htl1-klagenfurt/SCC/README.md

<p align="center">
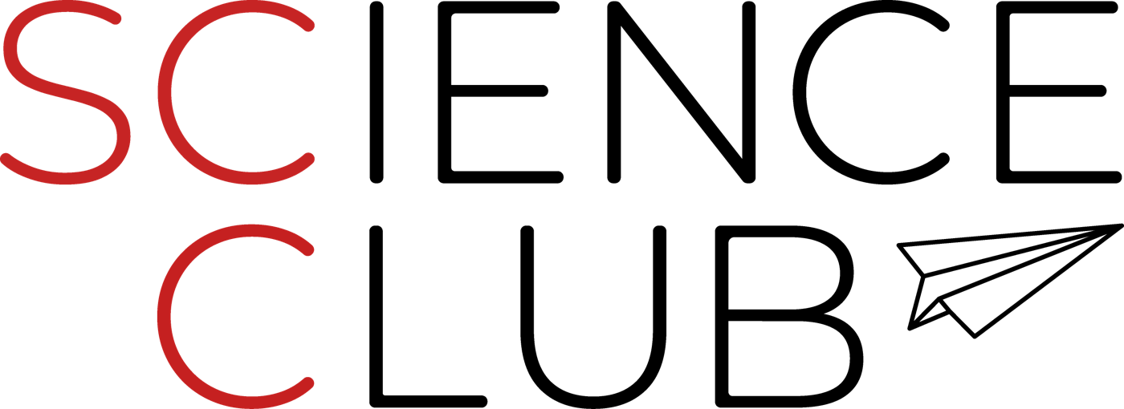
[picture p1: assets/science_club_logo.png]
Science Club
  
  &nbsp;&nbsp;&nbsp;&nbsp;
  <a href="https://htl1-klagenfurt.at">HTL1 Lastenstraße Klagenfurt</a>
</p>

# Science Club (SCC) – HTL1 Lastenstraße Klagenfurt

**Technik machen, nicht nur darüber reden.** · 🌐 [htl1-klagenfurt.github.io/SCC](https://htl1-klagenfurt.github.io/SCC/)

Im Science Club der [HTL1 Lastenstraße Klagenfurt](https://htl1-klagenfurt.at) entwickeln Schülerinnen und Schüler aus Elektrotechnik, Mechatronik und Maschinenbau echte Produkte: von der Idee über Elektronik, Software und 3D-gedrucktes Gehäuse bis zum fertigen Bausatz.

## Was ist ein Science Club?

Der Science Club ist eine unverbindliche Übung zur **Begabungs- und Begabtenförderung** in der Sekundarstufe I und II, mit einem Rahmencurriculum des Bildungsministeriums. Das Besondere sind die **Peer Groups**: Schülerinnen und Schüler der HTL1 (Sek II) entwickeln Projekte und geben ihr Wissen an Mittelschülerinnen und Mittelschüler (Sek I) weiter, die unter ihrer Anleitung selbst bauen. Im Mittelpunkt stehen Kreativität, kritisches Denken, Kommunikation und Kooperation.

## Die Idee: Lernen auf Augenhöhe

- **Machen:** Echte Projekte statt Übungen. Die Schülerinnen und Schüler entwickeln selbstständig, die Lehrer coachen.
- **Erklären:** Peer-Teaching. Wer etwas gebaut hat, gibt sein Wissen an Mittelschülerinnen und Mittelschüler weiter, die den Bausatz unter Anleitung selbst bauen und verstehen.
- **Raum:** Gemeinsam mit den Schülerinnen und Schülern haben wir die **Co-Creation Corner** geschaffen, selbst geplant, verkabelt und gebaut. Mit 3D-Drucker, Werkzeug, Laptops und Couch gibt sie dem Science Club Platz für die nächsten Projekte.

<sub>Science-Club-Konzept: DI(FH) Bernd Hollauf, MSc und DI Theodor Kranz, BSc BEd</sub>

## Projekte

| Projekt | Inhalt | Status |
|---|---|---|
| [**TimeFlow – die digitale Sanduhr**](timeflow/) | LED-Sanduhr mit zwei 8×8-Matrizen, Lagesensor und Akku im 3D-gedruckten Gehäuse | Prototyp und Workshops 2026 |

## Was passiert gerade?

| | |
|---|---|
| 🔜 **Als Nächstes** | Ende November / Anfang Dezember 2026: neue Workshops mit der MS Wölfnitz |
| ▶️ **Läuft gerade** | TimeFlow ist ein offener Bausatz: Firmware, Schaltplan, Druckdateien und Anleitungen sind online |
| ✅ **Zuletzt** | Sommersemester 2026: eigene Co-Creation Corner an der HTL1, von den Schüler:innen selbst geplant, verkabelt und gebaut · zwei Workshops mit der MS Wölfnitz |

Alle Stationen von der ersten Idee bis heute stehen im **[Logbuch](LOGBUCH.md)**.

## Nachbauen erlaubt, mit Namensnennung

Alle Unterlagen in diesem Repository dürfen für Unterricht, Workshops und private Projekte nachgebaut und angepasst werden. Bedingung ist, dass die HTL1 Lastenstraße Klagenfurt als Urheberin genannt, verlinkt und sichtbar gemacht wird. Details stehen in [ATTRIBUTION.md](ATTRIBUTION.md), die Lizenz in [LICENSE.md](LICENSE.md).

---

<sub>Science Club · HTL1 Lastenstraße Klagenfurt · Lastenstraße 1, 9020 Klagenfurt am Wörthersee · [htl1-klagenfurt.at](https://htl1-klagenfurt.at)</sub>
