htl1-klagenfurt/SCC/LOGBUCH.md

# Logbuch – Science Club HTL1

Was war, was läuft, was kommt. Neueste Einträge oben.

---

## 🔜 Als Nächstes

- [ ] **Ende November / Anfang Dezember 2026: neue Workshops mit der MS Wölfnitz** in der Co-Creation Corner
- [ ] **Nächstes SCC-Projekt** festlegen

## ▶️ Läuft gerade

- **Oktober 2026:** TimeFlow ist ein offener Bausatz. Firmware, Schaltplan, 3D-Druckdateien, Aufbau- und Bedienungsanleitung sind online.

## ✅ Was war

### Mai 2026: Zwei Workshops mit der MS Wölfnitz
Am 20. und 27. Mai bauen 12 Schülerinnen und Schüler der 4. Klassen der MS Wölfnitz ihre eigene, personalisierte TimeFlow und nehmen sie mit nach Hause. Unsere SCC-Mitglieder betreuen als Peer-Teacher vier Stationen: Programmierung, Konstruktion, 3D-Druck sowie Elektronik und Löten. Am Ende hält jede Gruppe eine eigene TimeFlow in der Hand.

### Sommersemester 2026: Ein eigener Raum: die Co-Creation Corner
Gemeinsam mit den Schülerinnen und Schülern entsteht an der HTL1 die Co-Creation Corner, ein eigener Raum für den Science Club mit 3D-Drucker, Werkzeug, Laptops und Couch. Die Schülerinnen und Schüler haben ihn selbst mitgestaltet: geplant, verkabelt und aufgebaut.

### Mai 2026: TimeFlow ist fertig
Gehäuse, Elektronik und Firmware sind fertig: Sanduhr, Uhr mit Wecker, Temperatur- und Feuchteanzeige und versteckte Easter Eggs. Auf der Rückseite führt ein QR-Code direkt zu diesem Repository.

### März 2026: Erste Prototypen
Die Elektronik läuft auf dem Steckbrett, der Sand „rieselt“ über zwei LED-Matrizen. Erste Gehäuse-Entwürfe entstehen im CAD.

### Februar 2026: Kick-off TimeFlow
14 Schülerinnen und Schüler aus Elektrotechnik, Mechatronik und Maschinenbau starten die Entwicklung. Ziel: eine digitale Sanduhr als Bausatz, den Mittelschüler unter Anleitung selbst bauen und verstehen.

### Dezember 2025: Planung der Co-Creation Corner
Grundriss und Farbkonzept für den eigenen Makerspace entstehen.

### Herbst 2025: Start des Science Club
Die HTL1 wird Teil der Science Club Community Carinthia (mit HTL Villach und Kärntner Mittelschulen). Erstes Planungstreffen mit der MS Wölfnitz. Ursprünglich war eine Sanduhr mit CO₂-Messung geplant, umgesetzt wurde sie mit Temperatur- und Feuchtemessung, damit der Bausatz einfach und robust bleibt.

---

<sub>Neuer Eintrag? Oben unter „Als Nächstes“ oder „Läuft gerade“ ergänzen und erledigte Punkte mit Datum nach „Was war“ verschieben.</sub>
