htl1-klagenfurt/SCC/ATTRIBUTION.md

# Namensnennung und Branding

TimeFlow und alle weiteren Projekte in diesem Repository wurden vom **Science Club der HTL1 Lastenstraße Klagenfurt** entwickelt. Wer sie nachbaut, weiterentwickelt, in Workshops einsetzt oder darüber berichtet, muss das sichtbar machen.

## Pflicht bei jeder Nutzung

1. **Nennen**, und zwar mit diesem Text (Deutsch oder Englisch):

   > **TimeFlow – ein Projekt des Science Club der HTL1 Lastenstraße Klagenfurt**
   > *TimeFlow – a project by the Science Club of HTL1 Lastenstraße Klagenfurt, Austria*

2. **Verlinken** auf beide Adressen:
   - https://htl1-klagenfurt.at
   - https://github.com/htl1-klagenfurt/SCC

3. **Sichtbar machen**
   - **Am Gerät:** Das Namensfeld „HTL1 Lastenstraße“ am Gehäuse bleibt erhalten. Wer das Gehäuse neu gestaltet, bringt den Hinweis „Design: HTL1 Lastenstraße Klagenfurt“ gut lesbar am Gerät an.
   - **In Unterlagen, Präsentationen, Websites und Social Media:** Der Nennungstext aus Punkt 1 und das HTL1-Logo erscheinen dort, wo das Projekt gezeigt wird.

4. **Änderungen kennzeichnen**, zum Beispiel: „Basierend auf TimeFlow der HTL1 Lastenstraße Klagenfurt, angepasst von …“

## Logos

Das HTL1-Logo und das Science-Club-Logo im Ordner [`assets/`](assets/) dürfen **nur zur Namensnennung** verwendet werden: unverändert und ohne den Eindruck, die HTL1 würde ein fremdes Produkt empfehlen oder verantworten. Die Logos fallen **nicht** unter die offene Lizenz dieses Repositorys.

## Kommerzielle Nutzung

Der Verkauf von Bausätzen, Geräten oder Kursen auf Basis von TimeFlow ist nur mit schriftlicher Zustimmung der HTL1 Lastenstraße Klagenfurt erlaubt.

## Kontakt

Science Club · HTL1 Lastenstraße Klagenfurt · Lastenstraße 1, 9020 Klagenfurt am Wörthersee · [htl1-klagenfurt.at](https://htl1-klagenfurt.at)
