htl1-klagenfurt/SCC/assets/corner/entwurf_ansicht.jpg

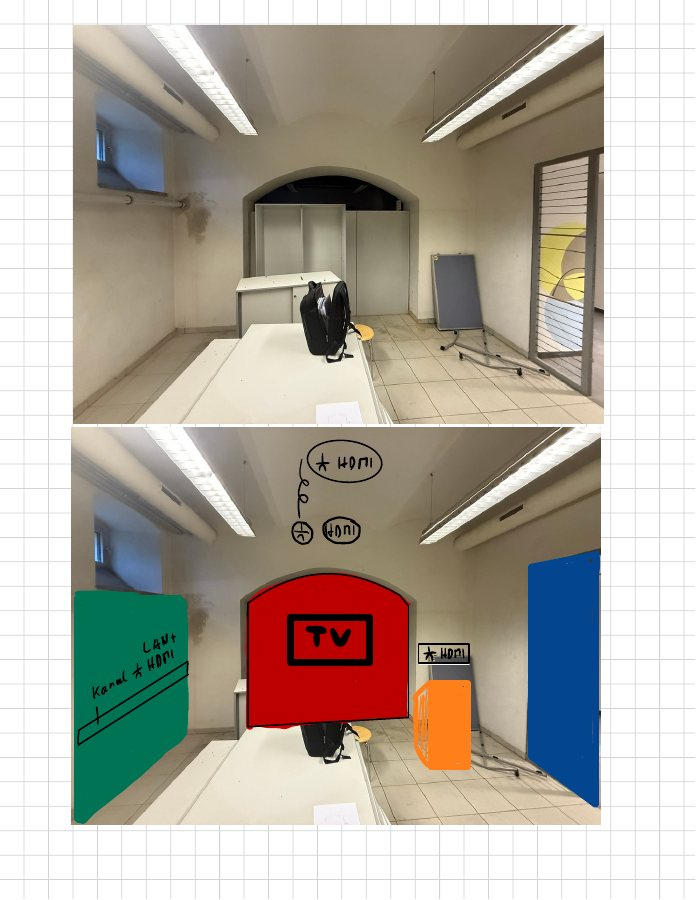
assets/corner/entwurf_ansicht.jpg
