htl1-klagenfurt/SCC/assets/corner/entwurf_grundriss.jpg

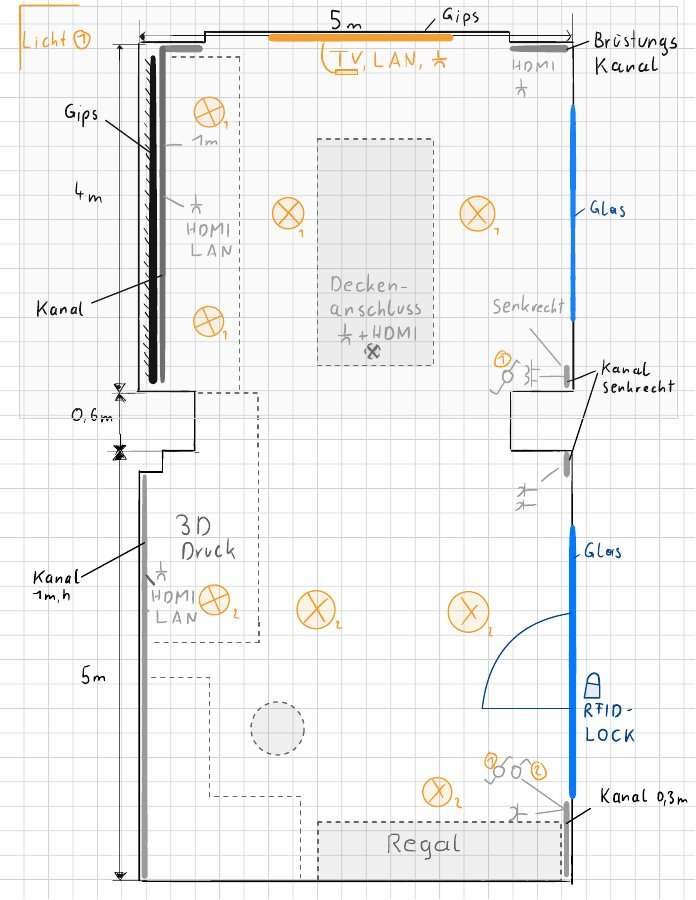
assets/corner/entwurf_grundriss.jpg
