htl1-klagenfurt/SCC/assets/corner/plakat_co_creation_corner.jpg

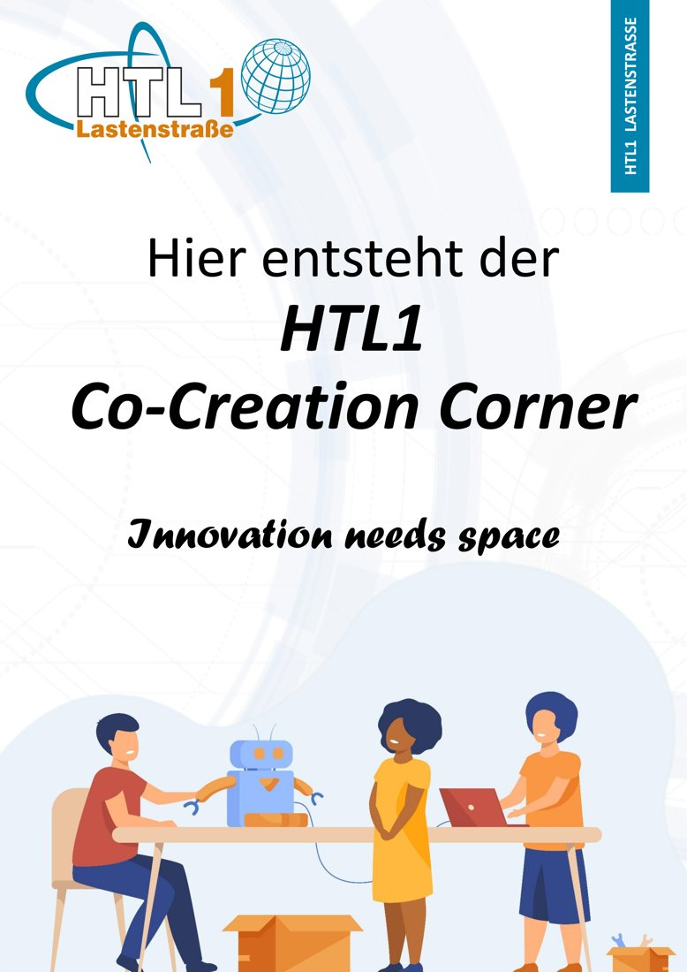
assets/corner/plakat_co_creation_corner.jpg
