htl1-klagenfurt/SCC/assets/corner/raum_vorher.jpg

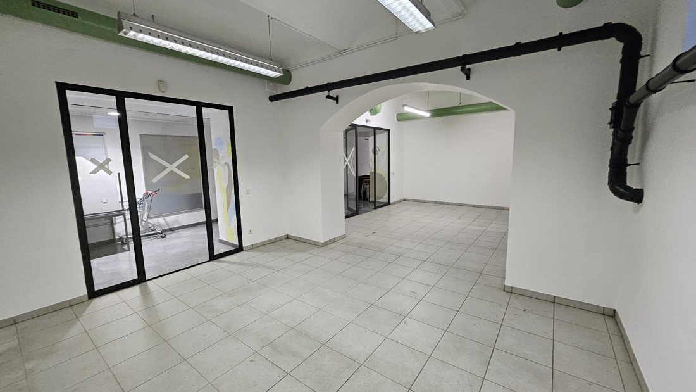
assets/corner/raum_vorher.jpg
