htl1-klagenfurt/SCC/assets/corner/team_co_creation_corner.jpg

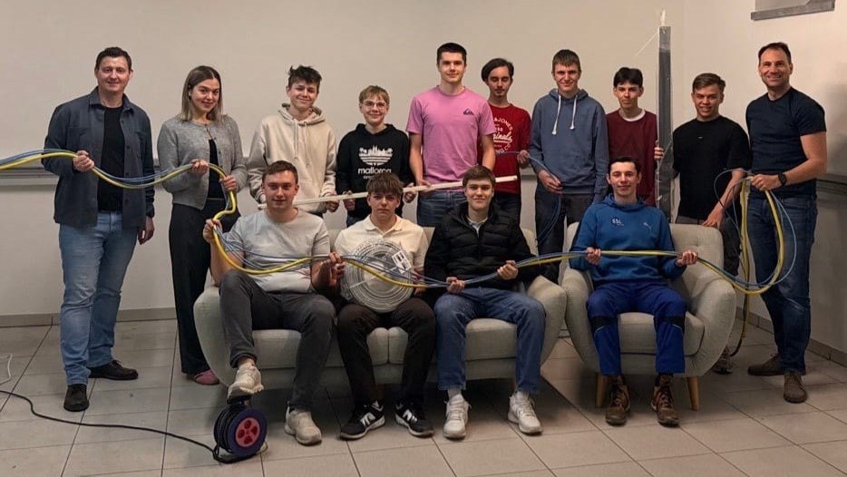
assets/corner/team_co_creation_corner.jpg
