htl1-klagenfurt/SCC/timeflow/bilder/foto_gehaeuse_offen.jpg

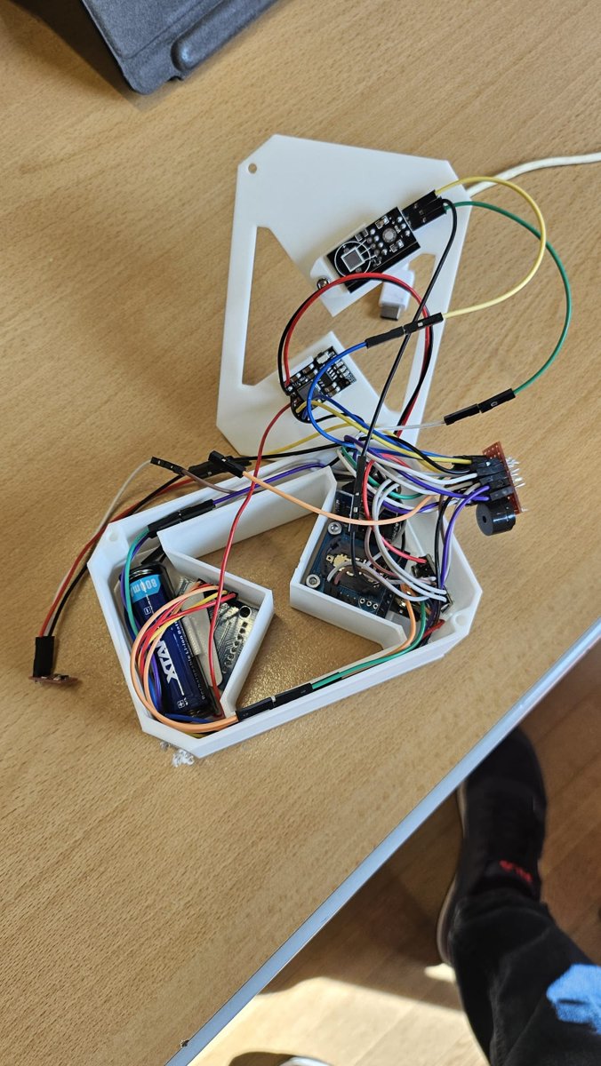
timeflow/bilder/foto_gehaeuse_offen.jpg
