htl1-klagenfurt/SCC/timeflow/bilder/foto_steckplatine.jpg

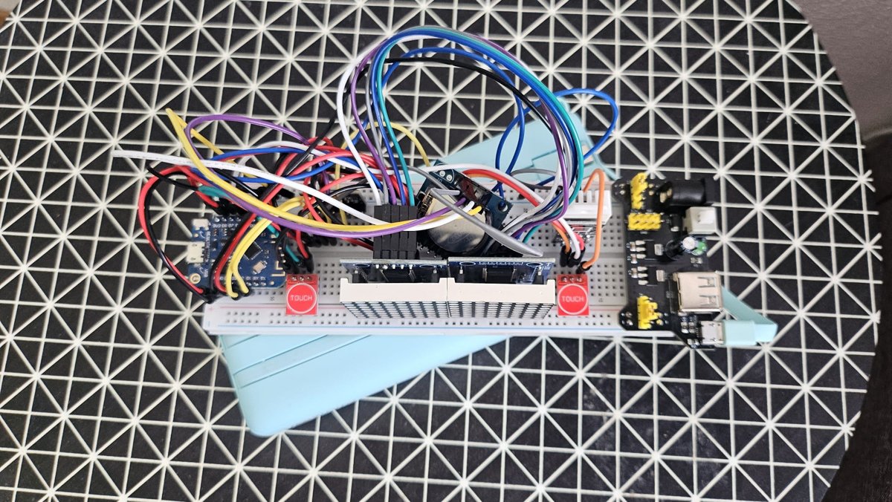
timeflow/bilder/foto_steckplatine.jpg
