htl1-klagenfurt/SCC/timeflow/bilder/foto_temperaturanzeige.jpg

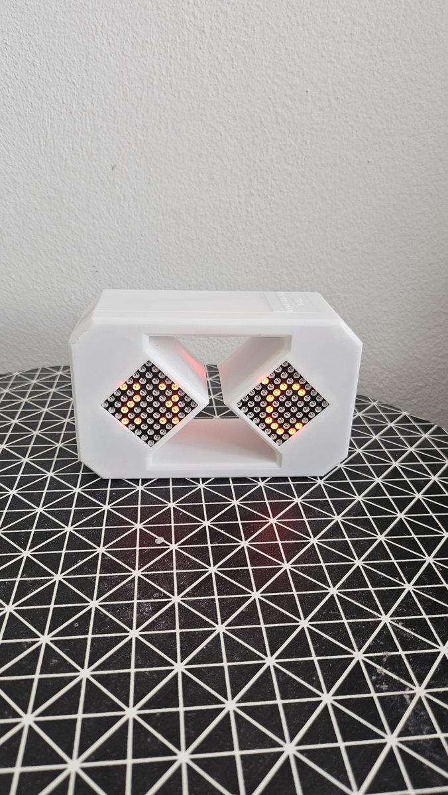
timeflow/bilder/foto_temperaturanzeige.jpg
