htl1-klagenfurt/SCC/timeflow/bilder/gehaeuse_cad_ansichten.jpg

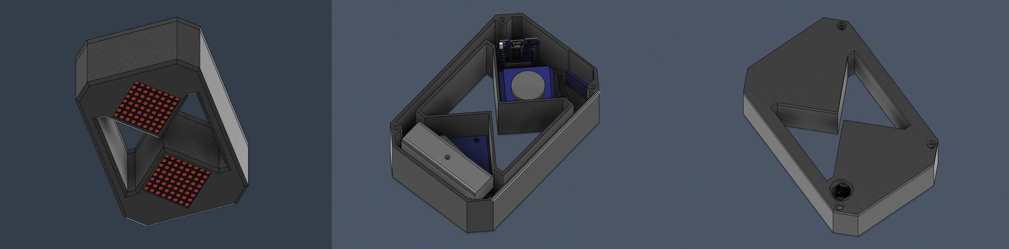
timeflow/bilder/gehaeuse_cad_ansichten.jpg
