htl1-klagenfurt/SCC/timeflow/bilder/gehaeuse_cad_offen.jpg

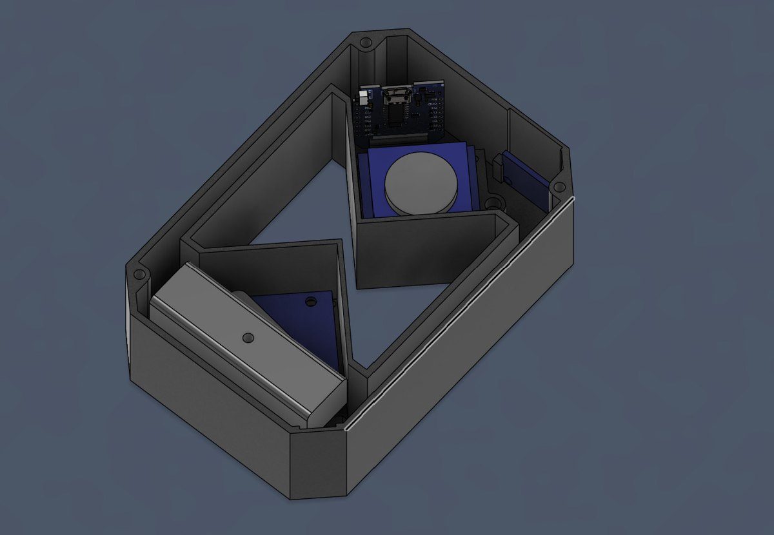
timeflow/bilder/gehaeuse_cad_offen.jpg
