htl1-klagenfurt/SCC/timeflow/bilder/gehaeuse_cad_rueckseite.jpg

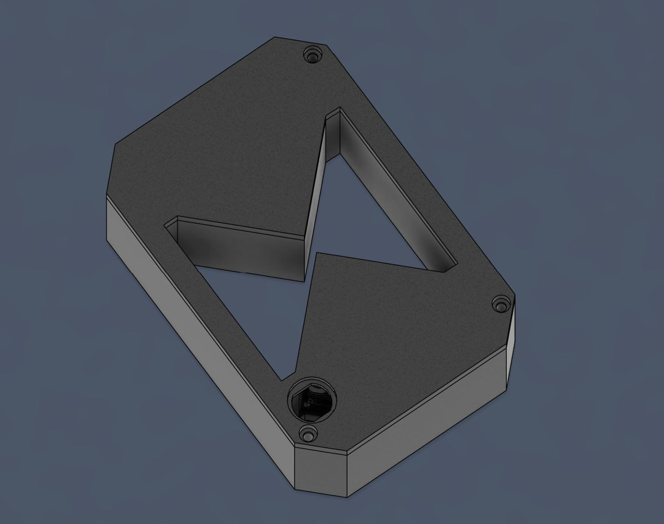
timeflow/bilder/gehaeuse_cad_rueckseite.jpg
