htl1-klagenfurt/SCC/timeflow/bilder/kickoff.jpg

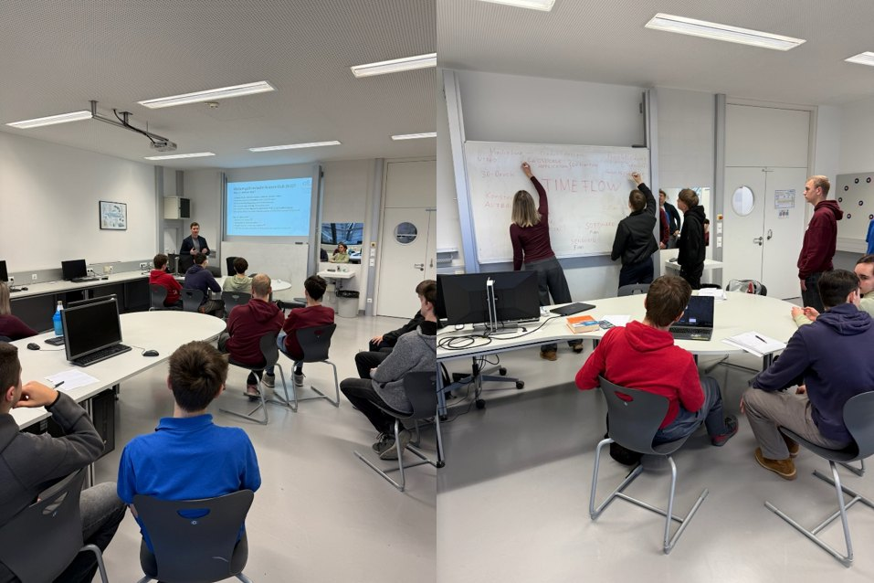
timeflow/bilder/kickoff.jpg
