htl1-klagenfurt/SCC/timeflow/bilder/plakat_htl1_trifft_ms_woelfnitz.jpg

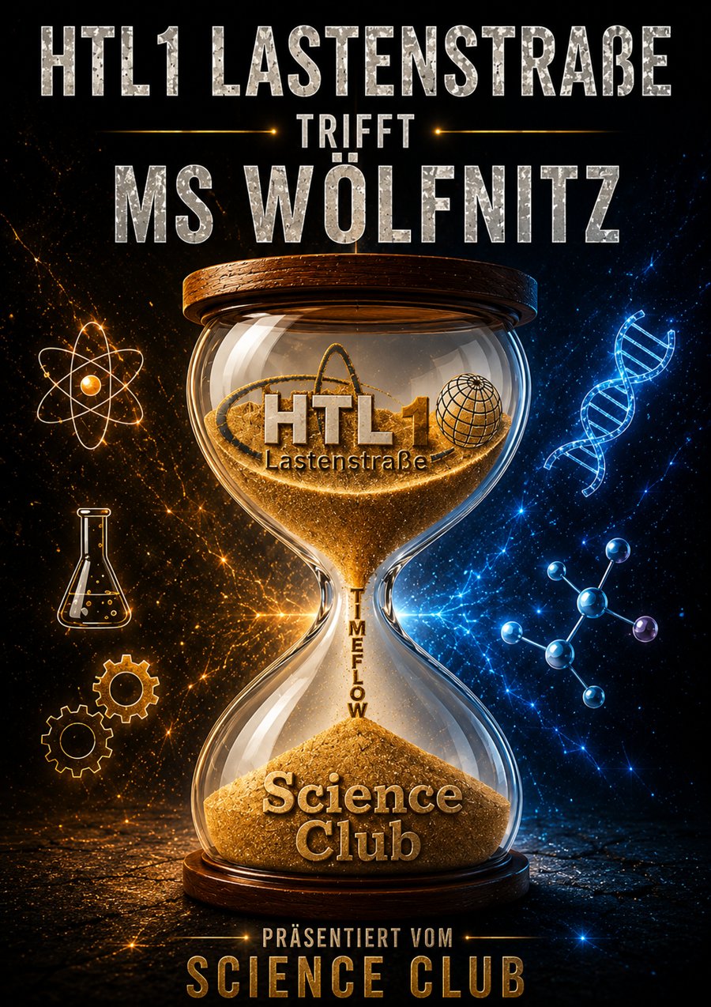
timeflow/bilder/plakat_htl1_trifft_ms_woelfnitz.jpg
