htl1-klagenfurt/SCC/timeflow/bilder/plakat_sanduhr_science_club.jpg

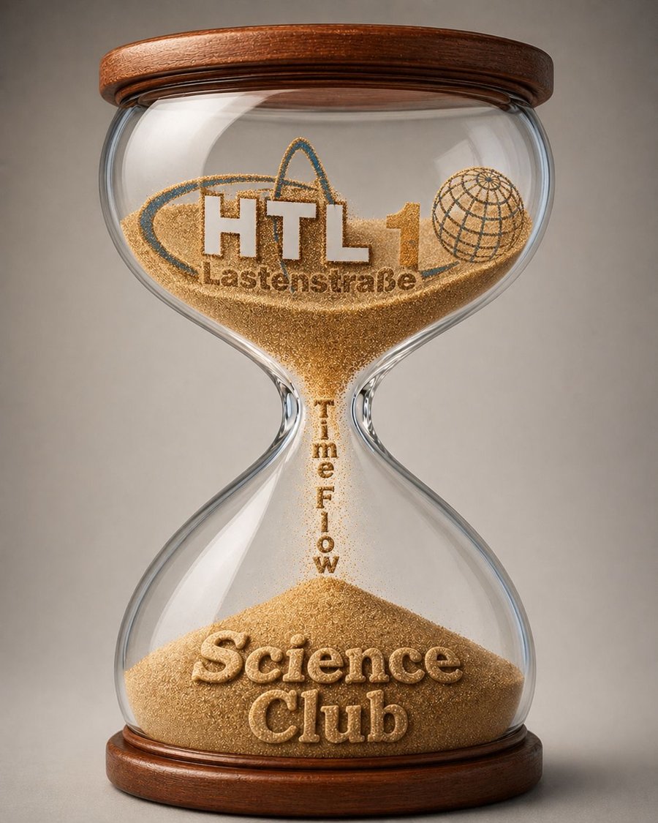
timeflow/bilder/plakat_sanduhr_science_club.jpg
