htl1-klagenfurt/SCC/timeflow/bilder/prototyp_sand.jpg

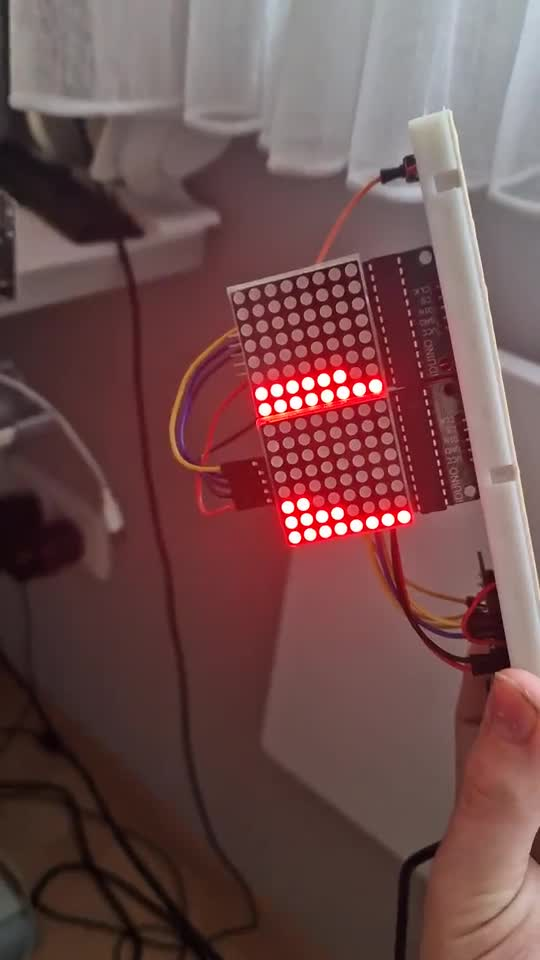
timeflow/bilder/prototyp_sand.jpg
