htl1-klagenfurt/SCC/timeflow/bilder/prototyp_steckbrett.jpg

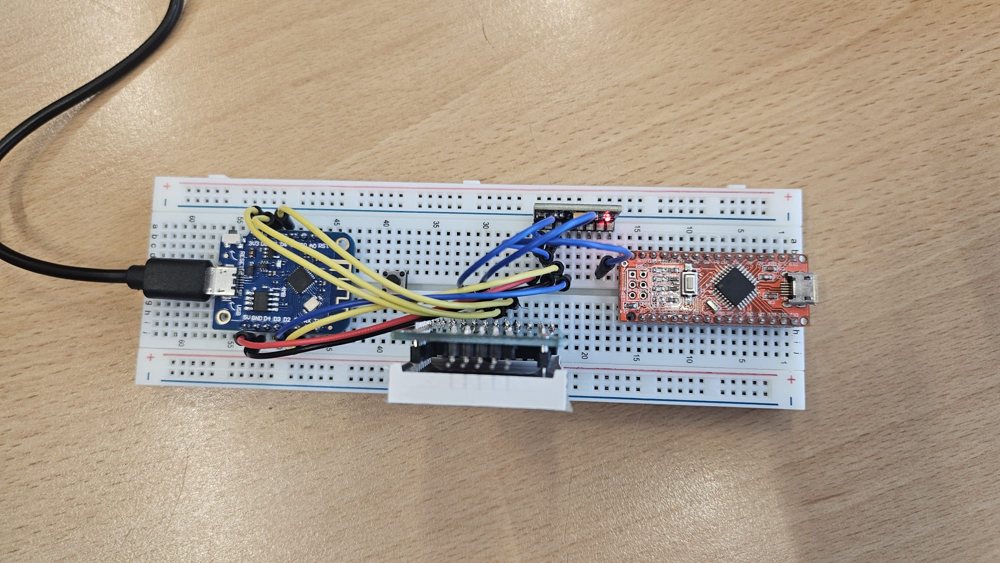
timeflow/bilder/prototyp_steckbrett.jpg
