htl1-klagenfurt/SCC/timeflow/bilder/timeflow_blau_modi.jpg

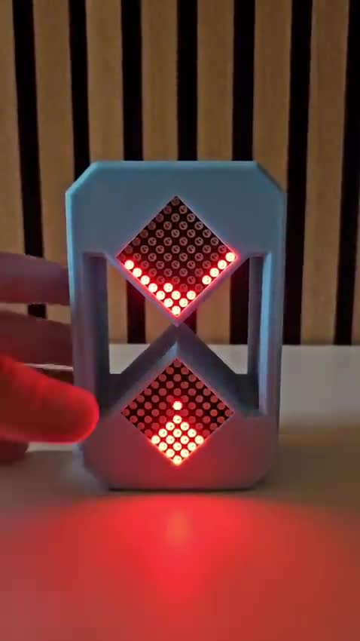
timeflow/bilder/timeflow_blau_modi.jpg
