htl1-klagenfurt/SCC/timeflow/bilder/timeflow_final.jpg

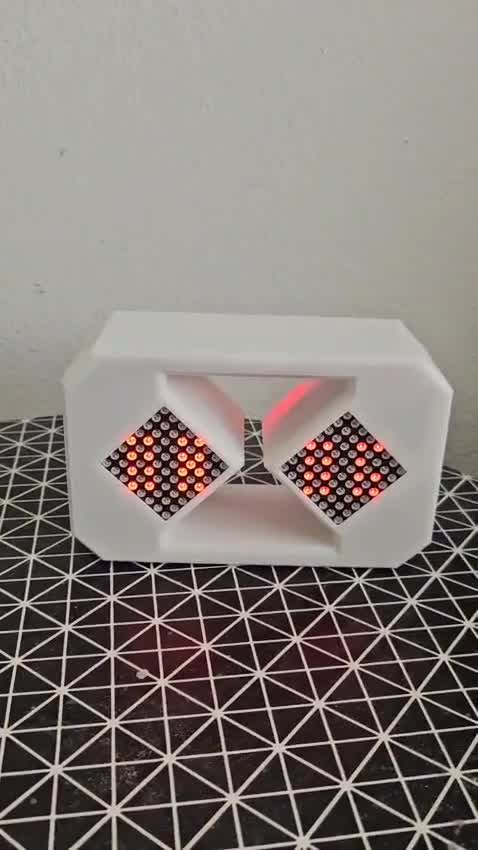
timeflow/bilder/timeflow_final.jpg
