htl1-klagenfurt/SCC/timeflow/cad/uhr_modul_halterung.step

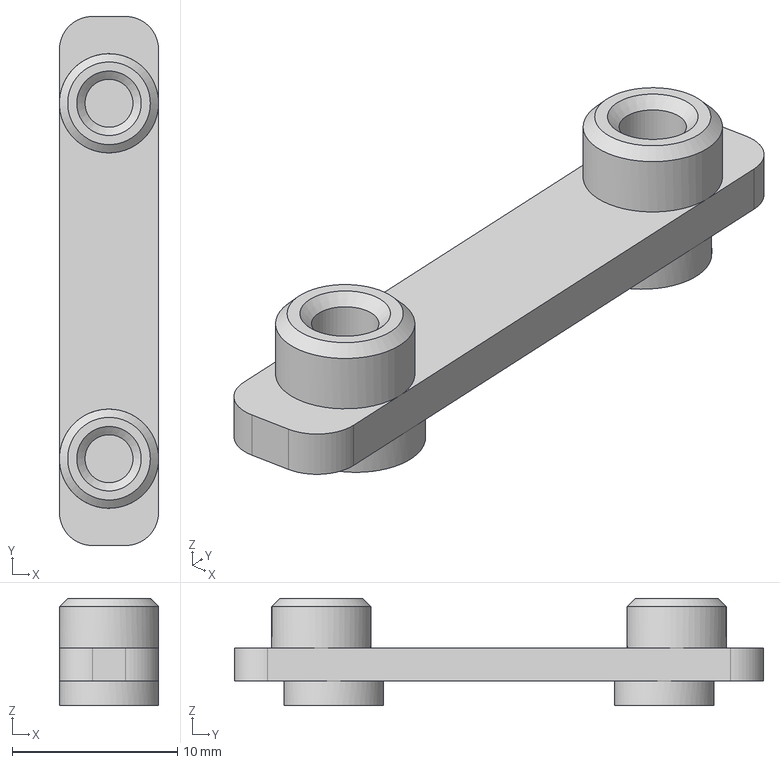
[picture p22: CAD file, 2026-10-20]
timeflow/cad/uhr_modul_halterung.step
6.00 x 32.0 x 6.50 mm
