htl1-klagenfurt/SCC/timeflow/druckdateien/02_Wand.3mf

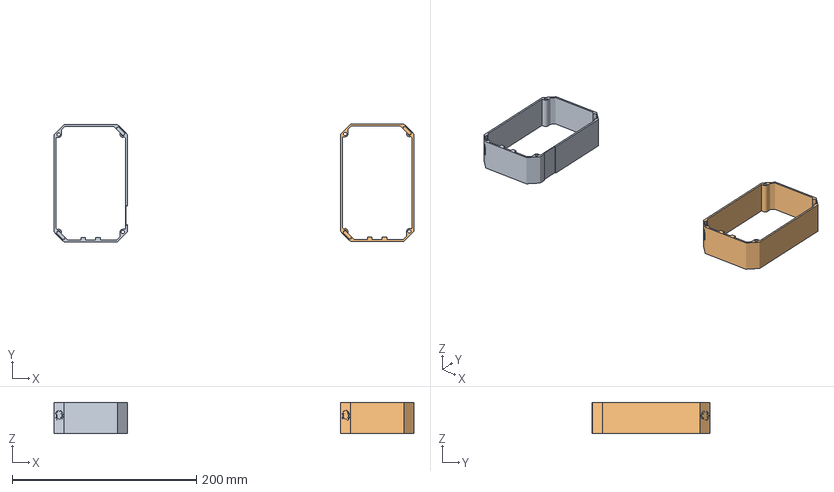
[picture p23: CAD file, 2026-10-20]
timeflow/druckdateien/02_Wand.3mf
390.9 x 128.3 x 34.0 mm
cad_md_Wand.step
cad_md_wand_ohne_namensfeld.step
