htl1-klagenfurt/SCC/timeflow/cad/wand_ohne_namensfeld.step

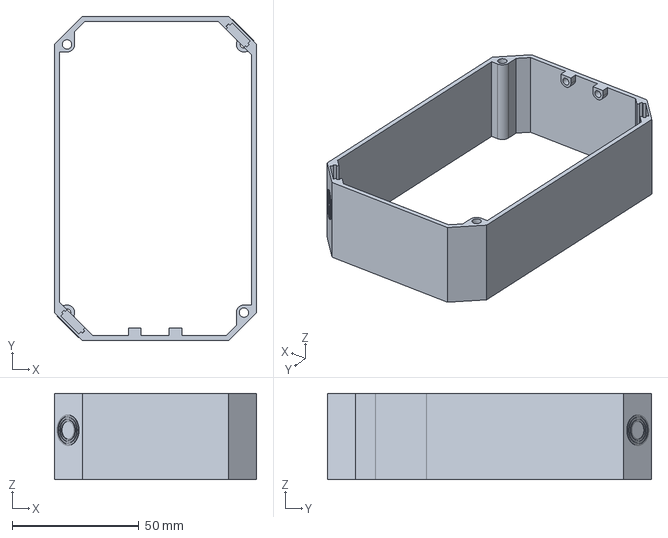
[picture p24: CAD file, 2026-10-20]
timeflow/cad/wand_ohne_namensfeld.step
79.7 x 127.7 x 34.0 mm
