htl1-klagenfurt/SCC/timeflow/druckdateien/01_Frontplatte.3mf

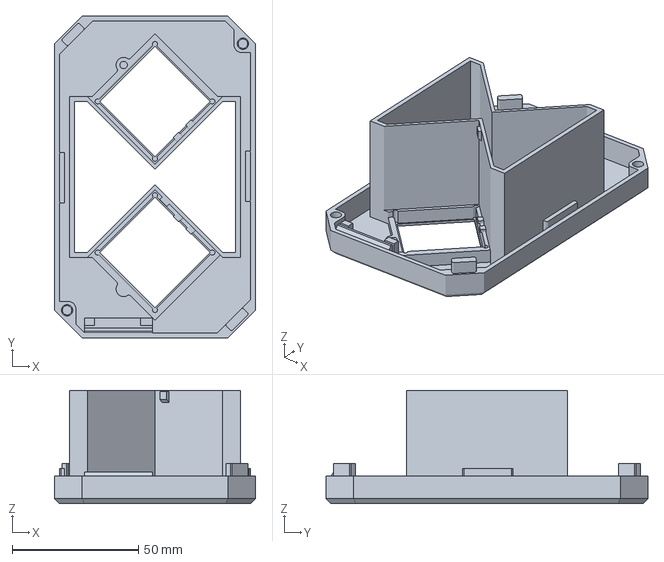
[picture p25: CAD file, 2026-10-20]
timeflow/druckdateien/01_Frontplatte.3mf
79.7 x 127.7 x 45.0 mm
