htl1-klagenfurt/SCC/timeflow/druckdateien/03_Rueckwand_Deckel.3mf

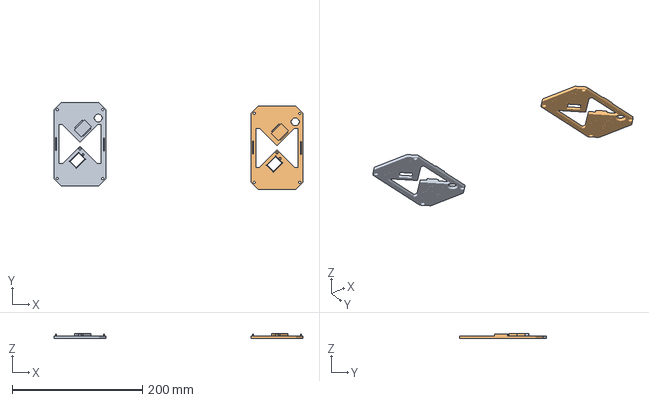
[picture p26: CAD file, 2026-10-20]
timeflow/druckdateien/03_Rueckwand_Deckel.3mf
381.8 x 133.5 x 8.00 mm
cad_md_deckel.step x 2
