htl1-klagenfurt/SCC/timeflow/cad/deckel.step

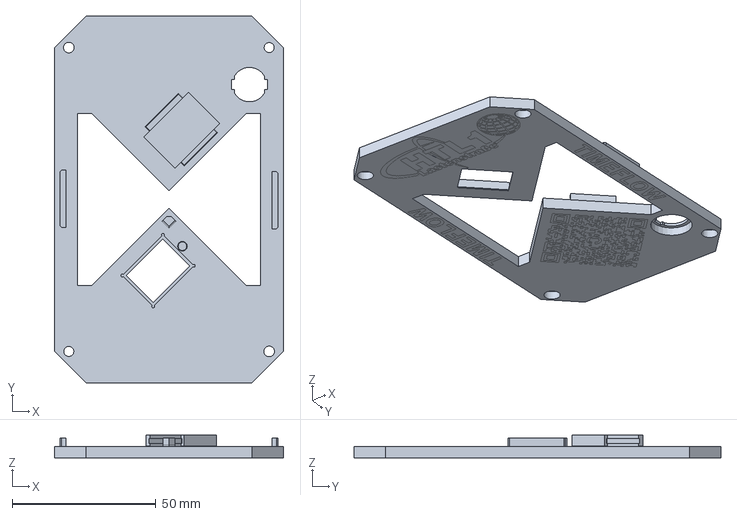
[picture p27: CAD file, 2026-10-20]
timeflow/cad/deckel.step
79.7 x 127.7 x 8.00 mm
