htl1-klagenfurt/SCC/timeflow/druckdateien/04_Kleinteile.3mf

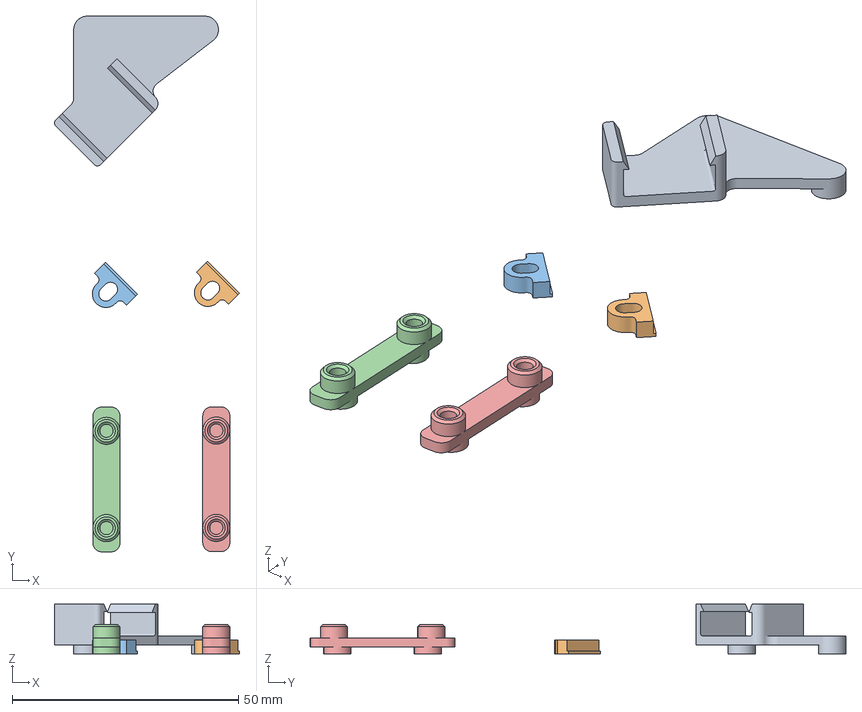
[picture p28: CAD file, 2026-10-20]
timeflow/druckdateien/04_Kleinteile.3mf
40.9 x 118.4 x 11.0 mm
cad_md_batterie_halterung.step
cad_md_matrix_klämme.step x 2
cad_md_uhr_modul_halterung.step x 2
