htl1-klagenfurt/SCC/timeflow/cad/batterie_halterung.step

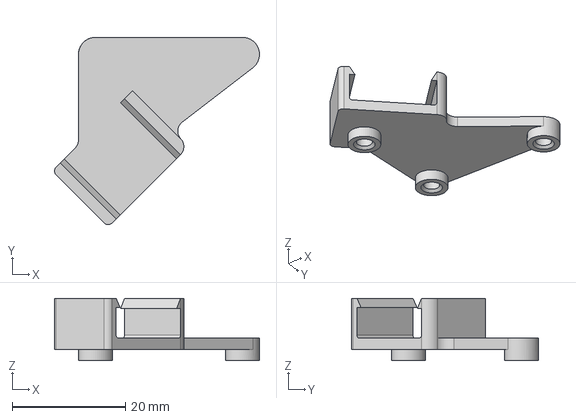
[picture p29: CAD file, 2026-10-20]
timeflow/cad/batterie_halterung.step
36.2 x 33.1 x 11.0 mm
