htl1-klagenfurt/SCC/timeflow/druckdateien/06_Gesamter_Timeflow.3mf

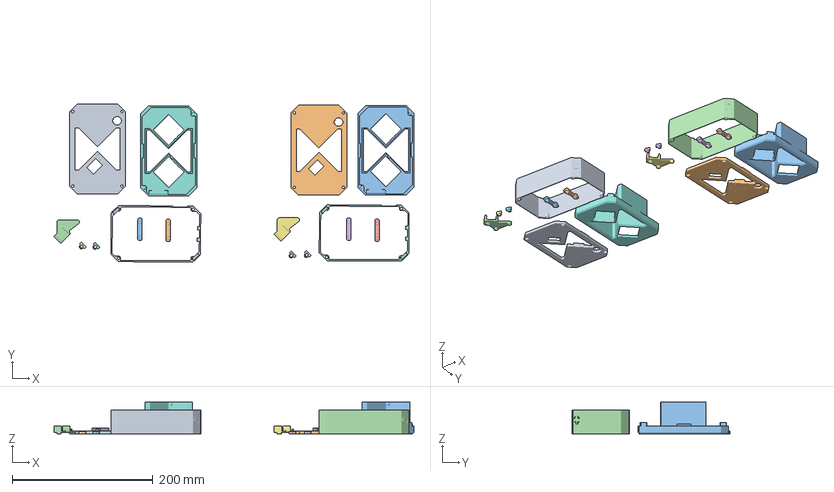
[picture p30: CAD file, 2026-10-20]
timeflow/druckdateien/06_Gesamter_Timeflow.3mf
511.9 x 224.7 x 45.0 mm
cad_md_deckel.step x 2
cad_md_LED_Matrix_halterung.step x 2
cad_md_Wand.step x 2
cad_md_uhr_modul_halterung.step x 4
cad_md_batterie_halterung.step x 2
cad_md_matrix_klämme.step x 4
