htl1-klagenfurt/SCC/timeflow/cad/matrix_klemme.step

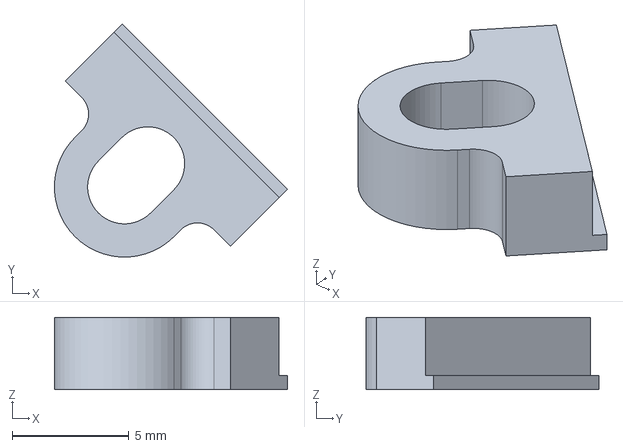
[picture p31: CAD file, 2026-10-20]
timeflow/cad/matrix_klemme.step
9.97 x 9.97 x 3.10 mm
