htl1-klagenfurt/SCC/(list of files, cad)

Other CAD files:
timeflow/cad/wand_mit_namensfeld.step
timeflow/cad/led_matrix_halterung.step
