htl1-klagenfurt/SCC/timeflow/anleitungen/TimeFlow_Bedienungsanleitung.pdf

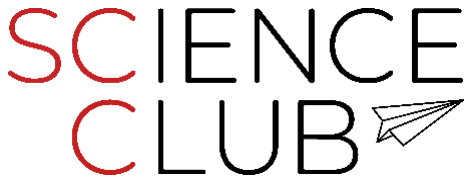
[picture p39: figure]

## Bedienungsanleitung Timeflow

Ein- und Ausschalten

Timeflow hat einen versteckten Ein-/Ausschaltknopf. Wenn das Gerät aufrecht steht, befindet er sich auf der linken, inneren, unteren Schrägfläche ganz hinten Unter dem Plastik. Einfach dort auf Das Plastik drücken.

Einschalten: 1× drücken
Ausschalten: 2× drücken

Aufladen

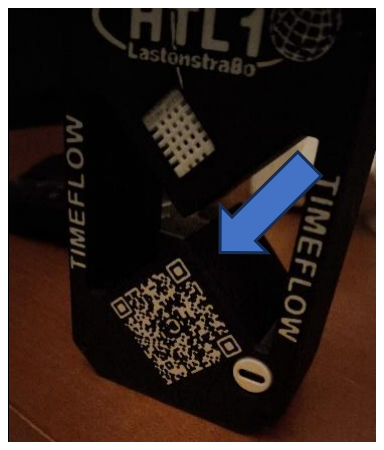
[picture p40: figure]

Timeflow wird über USB-C geladen – jedes handelsübliche Smartphone-Ladegerät funktioniert. Der Ladeanschluss befindet sich auf der Rückseite des Gehäuses.

GitHub & QR-Code

Auf der Rückseite des Gehäuses befindet sich ein QR-Code, der direkt zum GitHub-Projekt führt. Dort sind alle Projektdateien verfügbar:
– 3D-Druckdateien für das Gehäuse
– Bauanleitung
– Bedienungsanleitung
– Quellcode der Firmware
– weitere Informationen

Die Tasten

Timeflow hat zwei Tasten (oben rechts und unten links), beide haben identische Funktion. Erkennbar sind sie an den konzentrischen Ringen auf der Oberfläche.

Kurz drücken (1 Piepton)
Etwas länger (2. Piepton)
Noch länger (3. Piepton)

Modi wechseln

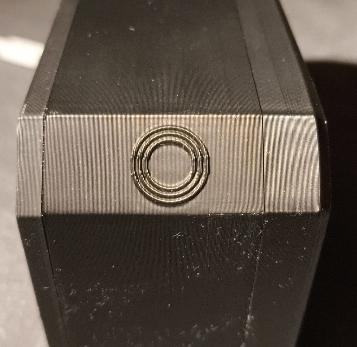
[picture p41: figure]

Gerät in die gewünschte Richtung drehen → kurz drücken (Bestätigungs-Piepton)

– Aufrecht (normal oder 180° gedreht): Sanduhr
– 90° nach links kippen: Uhr
– 90° nach rechts kippen: Info
– Flach auf den Rücken legen (Displays oben): Easter Egg

Sanduhr

Sandkörner fallen in Richtung der Schwerkraft – genau wie eine echte Sanduhr.

Laufzeit einstellen: Lange drücken bis zum 2. Piepton → Menü öffnet sich:
- H: Stunden: kurz drücken = erhöhen | etwas länger = verringern | noch länger = bestätigen
- M: Minuten: selbe Logik
- S: Sekunden: selbe Logik
Standard: 5 Sekunden Laufzeit.

Uhr

Zeigt die aktuelle Uhrzeit.

Wecker stellen: Lange drücken bis zum 2. Piepton → Stunden, dann Minuten einstellen (kurz = erhöhen, etwas länger = verringern, lang = bestätigen).
Aktiver Wecker: 2 Pixel an den Berührungspunkten der Displays blinken. Stoppen mit langem Drücken.

Uhrzeit synchronisieren: Noch länger drücken bis zum 3. Piepton → Aktuelle Uhrzeit eingeben (selbe Tastenbedienung).

Info

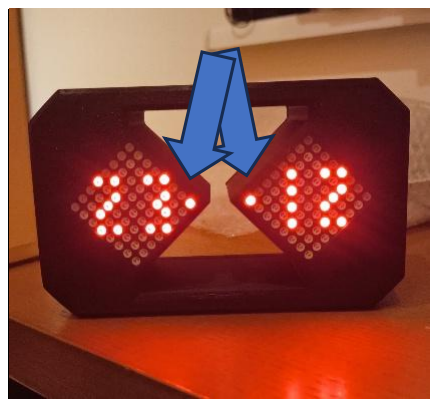
[picture p42: figure]

Wechselt automatisch zwischen Temperatur (°C) und Luftfeuchtigkeit (%) – keine Interaktion nötig. Für möglichst genau Messungen muss der Sensor auf der Rückseite freigehalten werden.

Easter Egg

Gerät auf den Rücken legen → kurz drücken.
Zwischen den Beiden Modi wechseln → lang drücken (2. Piepton)

– Animationen: Vorprogrammierte Animationen laufen auf beiden Displays. Schütteln wechselt zur nächsten.
– Labyrinth-Spiel:

Steuerung: Du bist der langsam blinkende Pixel. Ziel = schnell blinkender Pixel.
- Navigieren: Gerät in die Richtung neigen, in die du laufen möchtest (wie Schwerkraft) → kurz drücken = einen Schritt
- Orientierung: Das zweite Display zeigt einen Pfeil der in Richtung Ziel zeigt. Achtung!: Der Pfeil zeigt nicht den Weg zum Ziel, sondern nur die Position des Ziels an.

Schwierigkeitsstufen: Wird mit jedem mal Lösen schwieriger/größer. Nach dem 4. Level beginnt es wieder von vorne
8×8 → 16×16 → 32×32 → 64×64 Felder (zufällig generiert).

Spiel verlassen: Lange drücken (2.Piepton) → Animationen. Dann: Gerät aufrecht stellen und kurz drücken → in anderen Modus wechseln. (nur im Animationsmodus möglich!!)
