htl1-klagenfurt/SCC/timeflow/bilder/innenaufbau_led_matrizen.jpg

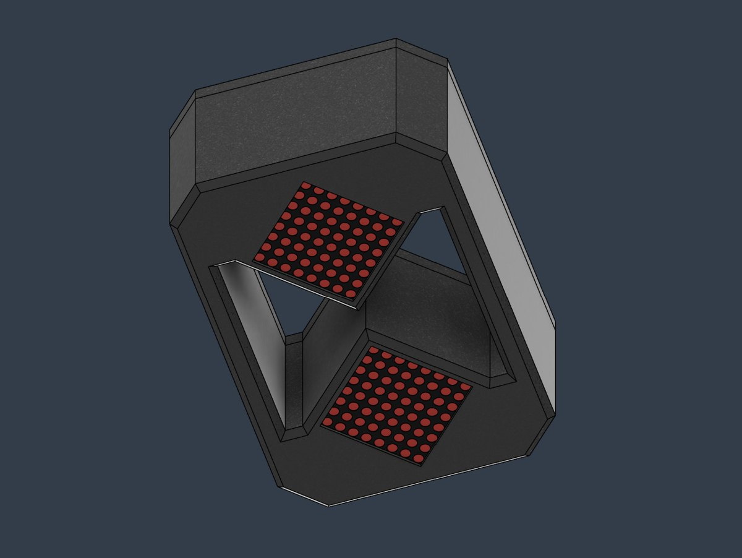
timeflow/bilder/innenaufbau_led_matrizen.jpg
