htl1-klagenfurt/SCC/timeflow/anleitungen/TimeFlow_Packungsliste.pdf

## Packungsliste – Digitale Sanduhr „Timeflow"

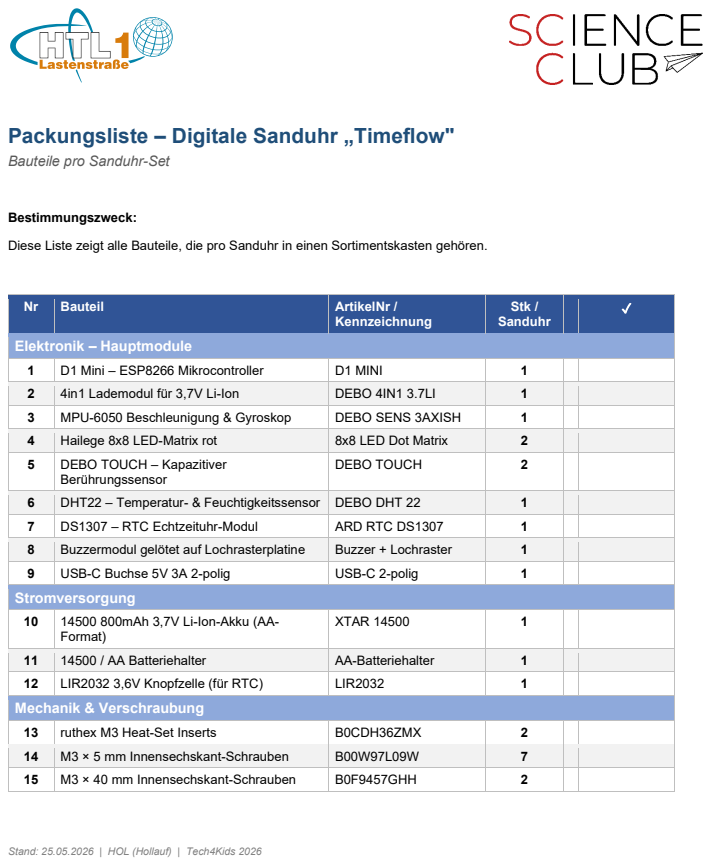
[picture p44: page 1]
Bestimmungszweck:; Bauteil; ArtikelNr /; Kennzeichnung; Stk / Sanduhr; Elektronik – Hauptmodule; DHT22 – Temperatur- & Feuchtigkeitssensor; DEBO DHT 22; DS1307 – RTC Echtzeituhr-Modul; ARD RTC DS1307; Buzzermodul gelötet auf Lochrasterplatine; Buzzer + Lochraster; USB-C Buchse 5V 3A 2-polig; USB-C 2-polig; Stromversorgung; XTAR 14500; Mechanik & Verschraubung; ruthex M3 Heat-Set Inserts; B0CDH36ZMX; M3 × 5 mm Innensechskant-Schrauben; M3 × 40 mm Innensechskant-Schrauben; B0F9457GHH

Bauteile pro Sanduhr-Set

Diese Liste zeigt alle Bauteile, die pro Sanduhr in einen Sortimentskasten gehören.

1 | D1 Mini – ESP8266 Mikrocontroller | D1 MINI | 1
2 | 4in1 Lademodul für 3,7V Li-Ion | DEBO 4IN1 3.7LI | 1
3 | MPU-6050 Beschleunigung & Gyroskop | DEBO SENS 3AXISH | 1
4 | Hailege 8x8 LED-Matrix rot | 8x8 LED Dot Matrix | 2
5 DEBO TOUCH – Kapazitiver | Berührungssensor | DEBO TOUCH | 2

10 14500 800mAh 3,7V Li-Ion-Akku (AA-
Format)

11 | 14500 / AA Batteriehalter | AA-Batteriehalter | 1
12 | LIR2032 3,6V Knopfzelle (für RTC) | LIR2032 | 1

Stand: 25.05.2026 | HOL (Hollauf) | Tech4Kids 2026
