htl1-klagenfurt/SCC/(list of files, drawings)

Other design files:
timeflow/fritzing/Digitale_Sanduhr_03.fzz
