htl1-klagenfurt/SCC/(commit log)

2026-10-20 Science Club: TimeFlow digital hourglass project
    [batterie_halterung.step, deckel.step, led_matrix_halterung.step, matrix_klemme.step, uhr_modul_halterung.step, wand_mit_namensfeld.step, wand_ohne_namensfeld.step]
2026-10-20 Add project logbook: past, current and next steps
2026-10-20 Use the CAD frame housing that was actually built; remove twisted concept renders
2026-10-20 TimeFlow: real firmware, schematic, print files, manuals, product photos and videos
    [01_Frontplatte.3mf, 02_Wand.3mf, 03_Rueckwand_Deckel.3mf, 04_Kleinteile.3mf, 06_Gesamter_Timeflow.3mf, Digitale_Sanduhr_03.fzz]
2026-10-20 TimeFlow page: simulation back in hero, video with background, features (maze, sensors, animation editor)
2026-10-20 Contact and credits: DI Bernd Hollauf and DI Theodor Kranz, BSc BEd
